AlviAhmed/RC_Car_433Mhz_Module_AVR/schematic/RC_Controller/rc_controller_basic/in_use_schem_pics/rc_motor_reciever_motor.png

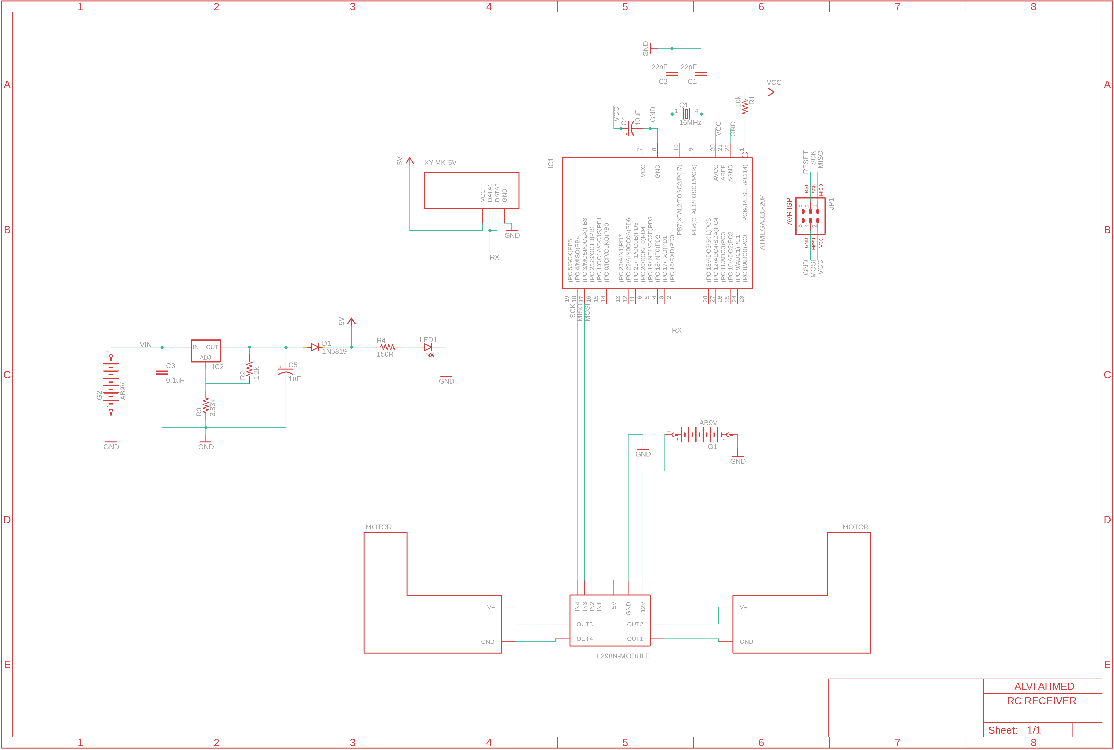
schematic/RC_Controller/rc_controller_basic/in_use_schem_pics/rc_motor_reciever_motor.png
