AlviAhmed/RC_Car_433Mhz_Module_AVR/schematic/RC_Controller/rc_controller_basic/prototype_schem_pics/rc_controller_basic.png

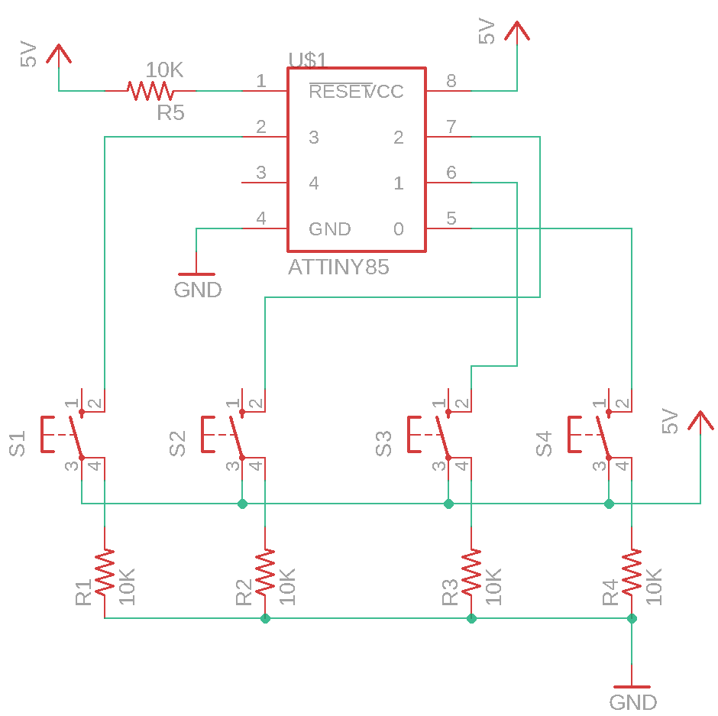
schematic/RC_Controller/rc_controller_basic/prototype_schem_pics/rc_controller_basic.png
