AlviAhmed/RC_Car_433Mhz_Module_AVR/schematic/RC_Controller/rc_controller_basic/rc_controller_prototype_reciever.sch

## EAGLE design schematic/RC_Controller/rc_controller_basic/rc_controller_prototype_reciever.sch (2020-10-17)

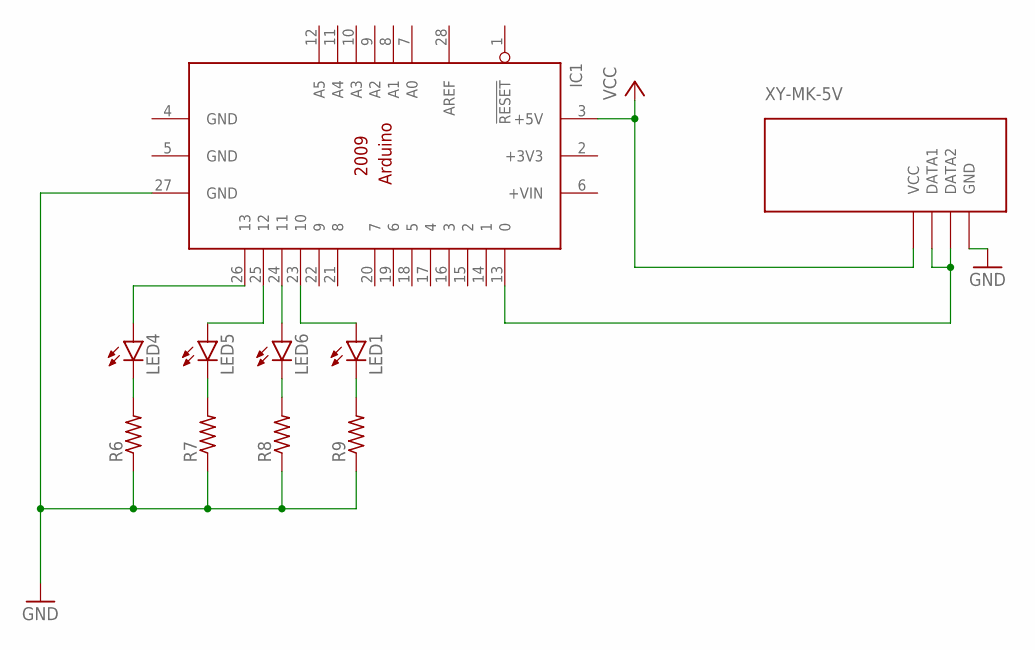
[picture p9: schematic rc_controller_prototype_reciever.sch]

Parts:
IC1: ARDUINO2009_10; ARDUINO2009
LED1, LED4, LED5, LED6: LED5MM
R6, R7, R8, R9: R-US_0204/7; 0204/7

Connections:
GND: IC1.27 (GND), R6.1, R7.1, R8.1, R9.1
unnamed: IC1.26 (13), LED4.A
unnamed: IC1.25 (12), LED5.A
unnamed: IC1.24 (11), LED6.A
unnamed: IC1.23 (10), LED1.A
unnamed: LED4.K (C), R6.2
unnamed: LED5.K (C), R7.2
unnamed: LED6.K (C), R8.2
unnamed: LED1.K (C), R9.2
VCC: IC1.3 (+5V)
