AlviAhmed/RC_Car_433Mhz_Module_AVR/schematic/RC_Controller/rc_controller_basic/rc_controller_prototype_transmitter.sch

## EAGLE design schematic/RC_Controller/rc_controller_basic/rc_controller_prototype_transmitter.sch (2020-10-17)

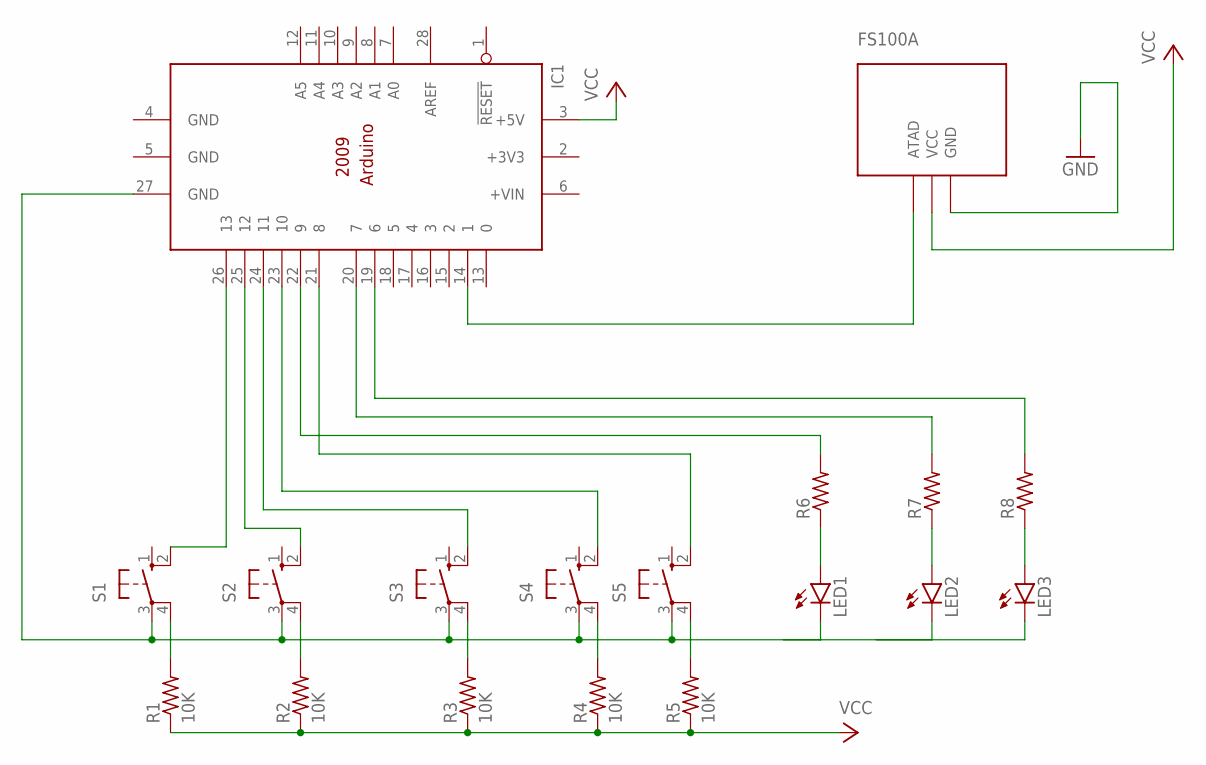
[picture p10: schematic rc_controller_prototype_transmitter.sch]

Parts:
IC1: ARDUINO2009_10; ARDUINO2009
LED1, LED2, LED3: LED5MM
R1, R2, R3, R4, R5: 10K; 0204/5
R6, R7, R8: R-US_0204/7; 0204/7
S1, S2, S3, S4, S5: 10-XX; B3F-10XX

Connections:
unnamed: IC1.26 (13), S1.2 (S1)
unnamed: R1.2, S1.4 (P1)
unnamed: R2.2, S2.4 (P1)
unnamed: R3.2, S3.4 (P1)
unnamed: R4.2, S4.4 (P1)
unnamed: IC1.22 (9), R6.2
unnamed: IC1.25 (12), S2.2 (S1)
unnamed: IC1.23 (10), S4.2 (S1)
unnamed: IC1.24 (11), S3.2 (S1)
unnamed: R5.2, S5.4 (P1)
unnamed: IC1.27 (GND), LED1.K (C), S1.3, S2.3, S3.3, S4.3, S5.3
unnamed: LED1.A, R6.1
unnamed: IC1.21 (8), S5.2 (S1)
unnamed: IC1.20 (7), R7.2
unnamed: LED2.A, R7.1
unnamed: IC1.19 (6), R8.2
unnamed: LED3.A, R8.1
VCC: IC1.3 (+5V), R1.1, R2.1, R3.1, R4.1, R5.1
