AlviAhmed/RC_Car_433Mhz_Module_AVR/schematic/RC_Controller/rc_controller_basic/rc_controller_reciever.sch

## EAGLE design schematic/RC_Controller/rc_controller_basic/rc_controller_reciever.sch (2020-10-17)

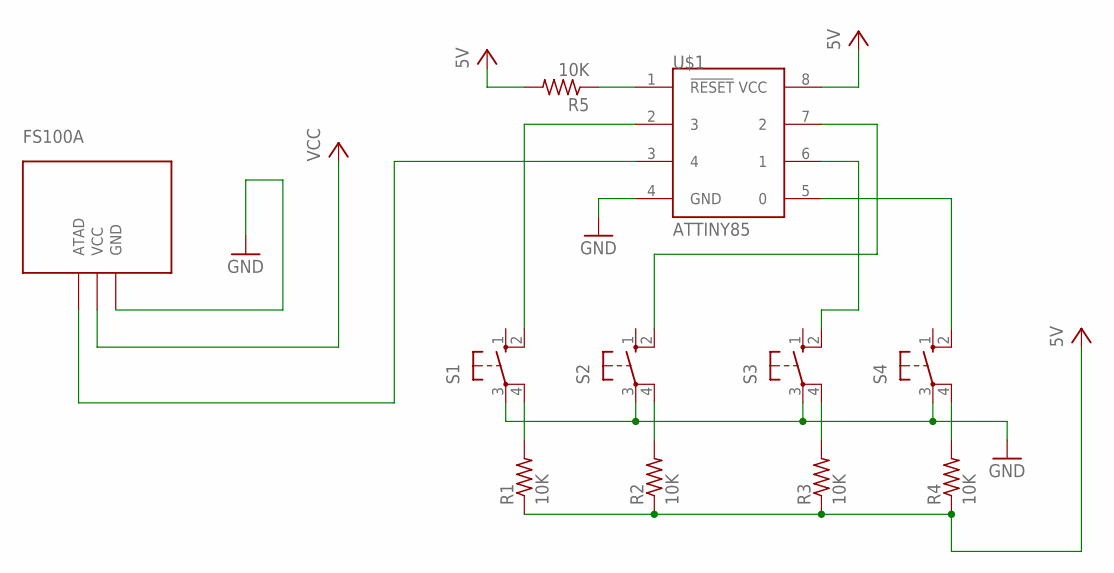
[picture p11: schematic rc_controller_reciever.sch, sheet 1]

Parts:
R1, R2, R3, R4, R5: 10K; 0204/5
S1, S2, S3, S4: 10-XX; B3F-10XX
U$1: ATTINY85; 8P3

Connections:
GND: S1.3, S2.3, S3.3, S4.3, U$1.4 (GND)
unnamed: R5.1, U$1.1 (!RESET)
unnamed: R1.2, S1.4 (P1)
unnamed: R2.2, S2.4 (P1)
unnamed: R3.2, S3.4 (P1)
unnamed: R4.2, S4.4 (P1)
unnamed: S1.2 (S1), U$1.2 (3)
unnamed: S2.2 (S1), U$1.7 (2)
unnamed: S3.2 (S1), U$1.6 (1)
unnamed: S4.2 (S1), U$1.5 (0)
TO_TRANSMITTER: U$1.3 (4)
VCC: R1.1, R2.1, R3.1, R4.1, R5.2, U$1.8 (VCC)
