AlviAhmed/RC_Car_433Mhz_Module_AVR/schematic/RC_Controller/rc_controller_basic/rc_controller_reciever_motor_actual.sch

## EAGLE design schematic/RC_Controller/rc_controller_basic/rc_controller_reciever_motor_actual.sch (2020-11-09)

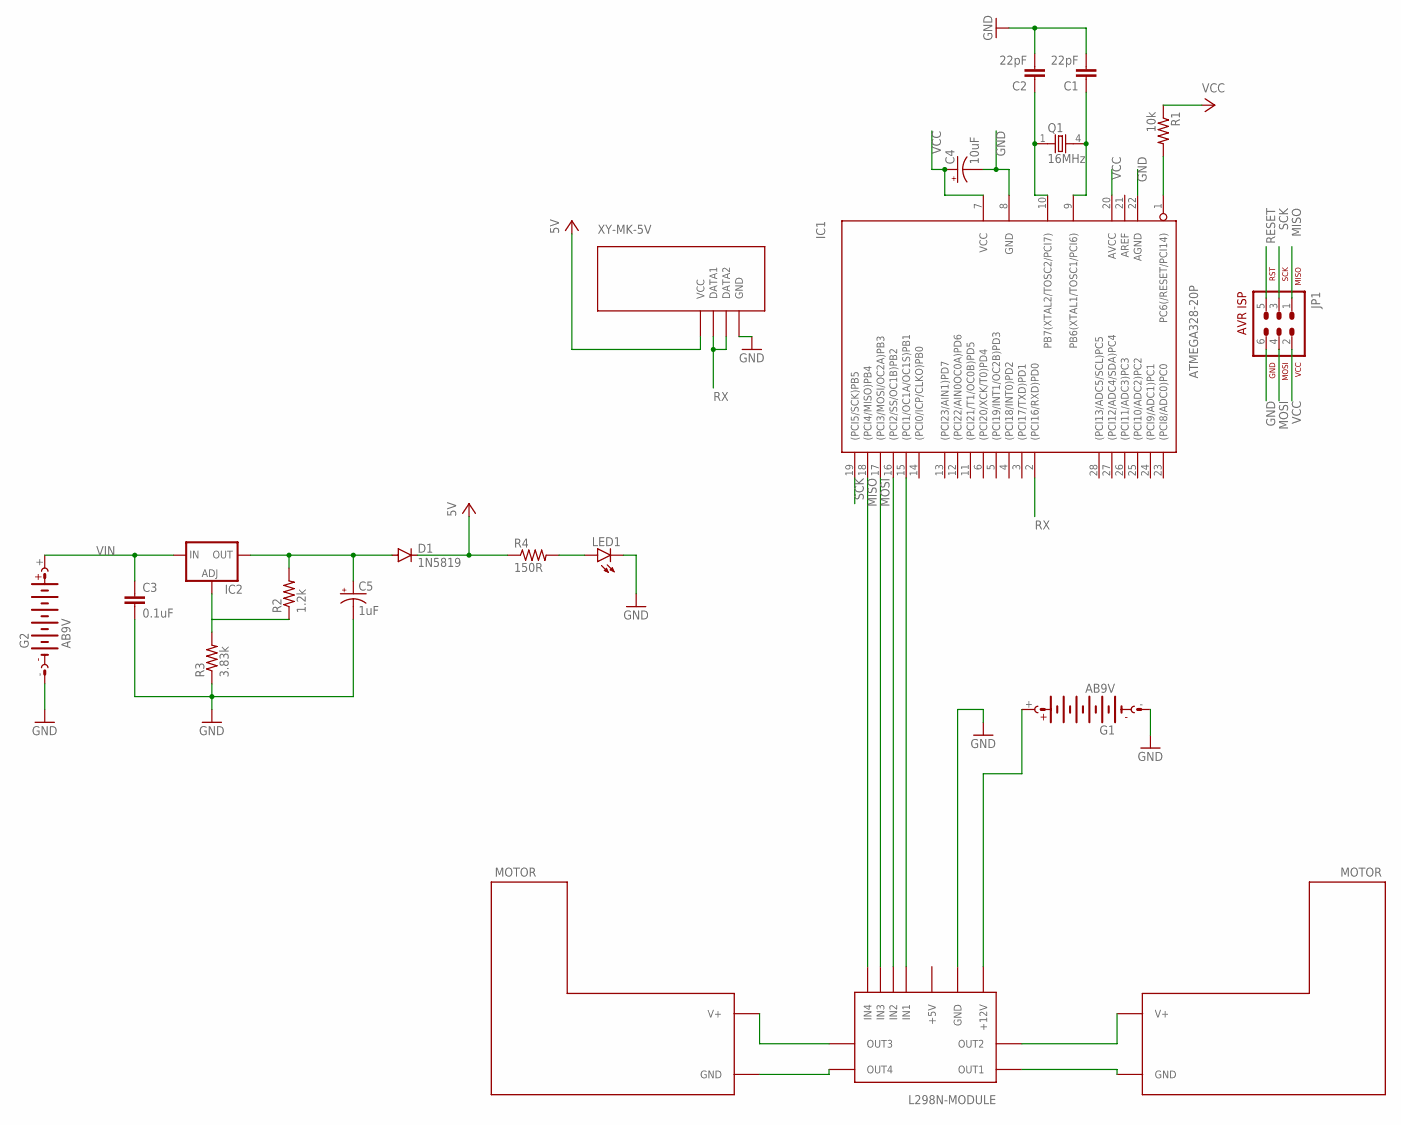
[picture p12: schematic rc_controller_reciever_motor_actual.sch]

Parts:
C1, C2: 22pF; C2.5-3
C3: 0.1uF; C2.5-3
C4: 10uF; 085CS_1AW
C5: 1uF; 153CLV-0810
D1: 1N5819; DO41-10
G1, G2: AB9V
IC1: ATMEGA328-20P; DIL28-3
IC2: LM317TL; 317TL
JP1: AVR-ISP-6VERT; AVR-ISP-6
LED1: LAP4-BOTTOM; P47F-BOTTOM
Q1: 16MHz; 86SMX
R1: 10k; 0204/7
R2: 1.2k; 0204/7
R3: 3.83k; 0204/7
R4: 150R; 0204/7

Connections:
GND: C1.2, C2.1, C2.2, C3.2, C4.-, C5.-, G1.-, G2.-, IC1.8 (GND), IC1.10 (PB7(XTAL2/TOSC2/PCI7)), IC1.22 (AGND), JP1.6, LED1.C, Q1.1, R3.1
MISO: IC1.18 ((PCI4/MISO)PB4), JP1.1
MOSI: IC1.17 ((PCI3/MOSI/OC2A)PB3), JP1.4
unnamed: IC2.1 (ADJ), R2.1, R3.2
unnamed: C1.1, IC1.9 (PB6(XTAL1/TOSC1/PCI6)), Q1.4 (2)
unnamed: IC1.1 (PC6(/RESET/PCI14)), R1.2
unnamed: C5.+, D1.A, IC2.2 (OUT), R2.2
unnamed: LED1.A, R4.2
RESET: JP1.5
RX: IC1.2 ((PCI16/RXD)PD0)
SCK: IC1.19 ((PCI5/SCK)PB5), JP1.3
VCC: C4.+, D1.C, IC1.7 (VCC), IC1.20 (AVCC), JP1.2, R1.1, R4.1
VIN: C3.1, G2.+, IC2.3 (IN)
