AlviAhmed/RC_Car_433Mhz_Module_AVR/schematic/RC_Controller/rc_controller_basic/rc_controller_reciever_motor_prototype.sch

## EAGLE design schematic/RC_Controller/rc_controller_basic/rc_controller_reciever_motor_prototype.sch (2020-10-23)

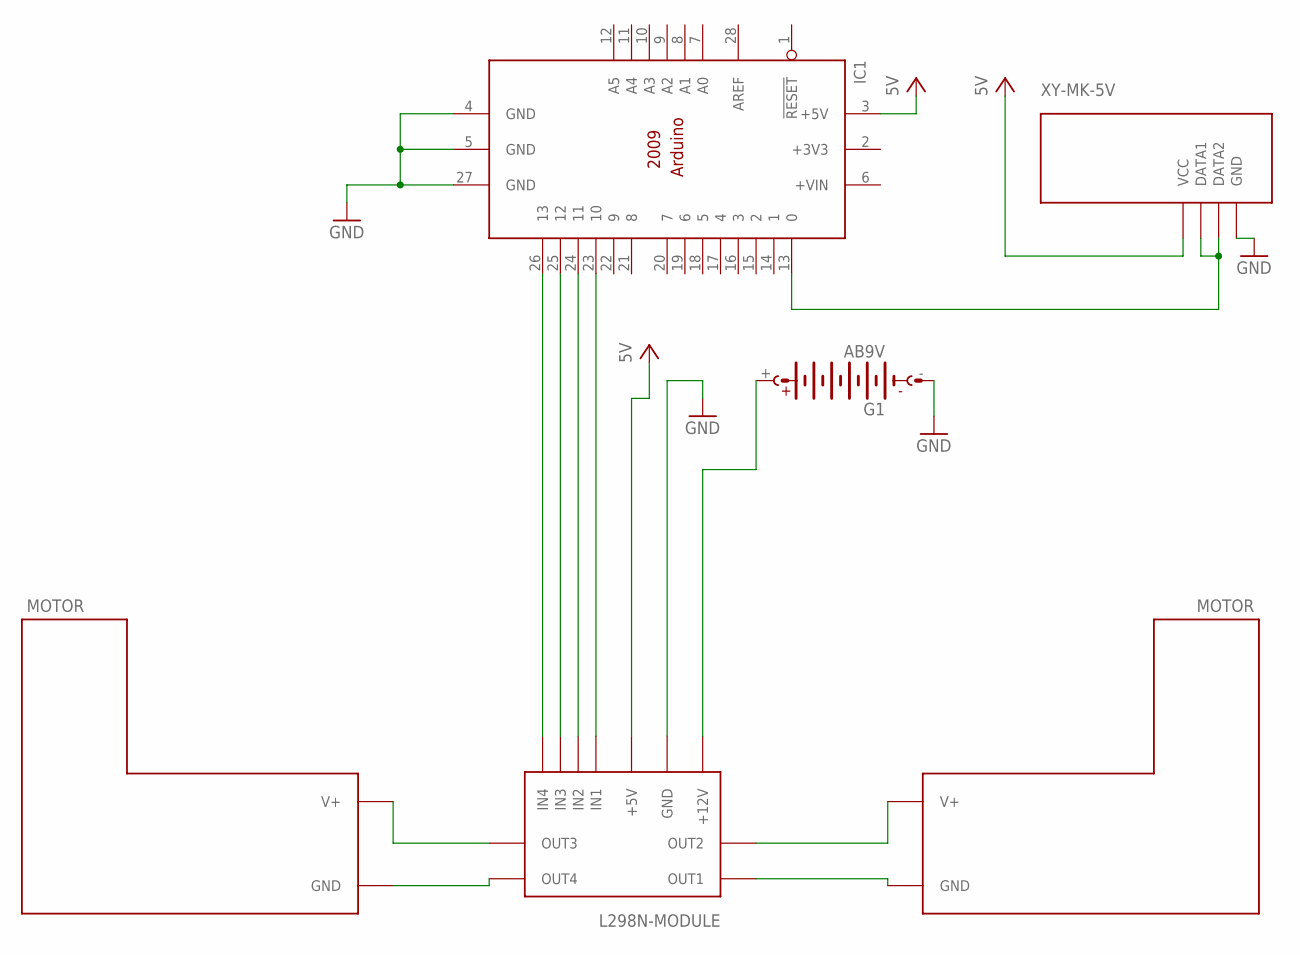
[picture p13: schematic rc_controller_reciever_motor_prototype.sch]

Parts:
G1: AB9V
IC1: ARDUINO2009_10; ARDUINO2009

Connections:
GND: G1.-, IC1.4 (GND), IC1.5 (GND), IC1.27 (GND)
VCC: IC1.3 (+5V)
