AlviAhmed/RC_Car_433Mhz_Module_AVR/schematic/RC_Controller/rc_controller_basic/rc_controller_transmitter_comp.sch

## EAGLE design schematic/RC_Controller/rc_controller_basic/rc_controller_transmitter_comp.sch (2020-11-09)

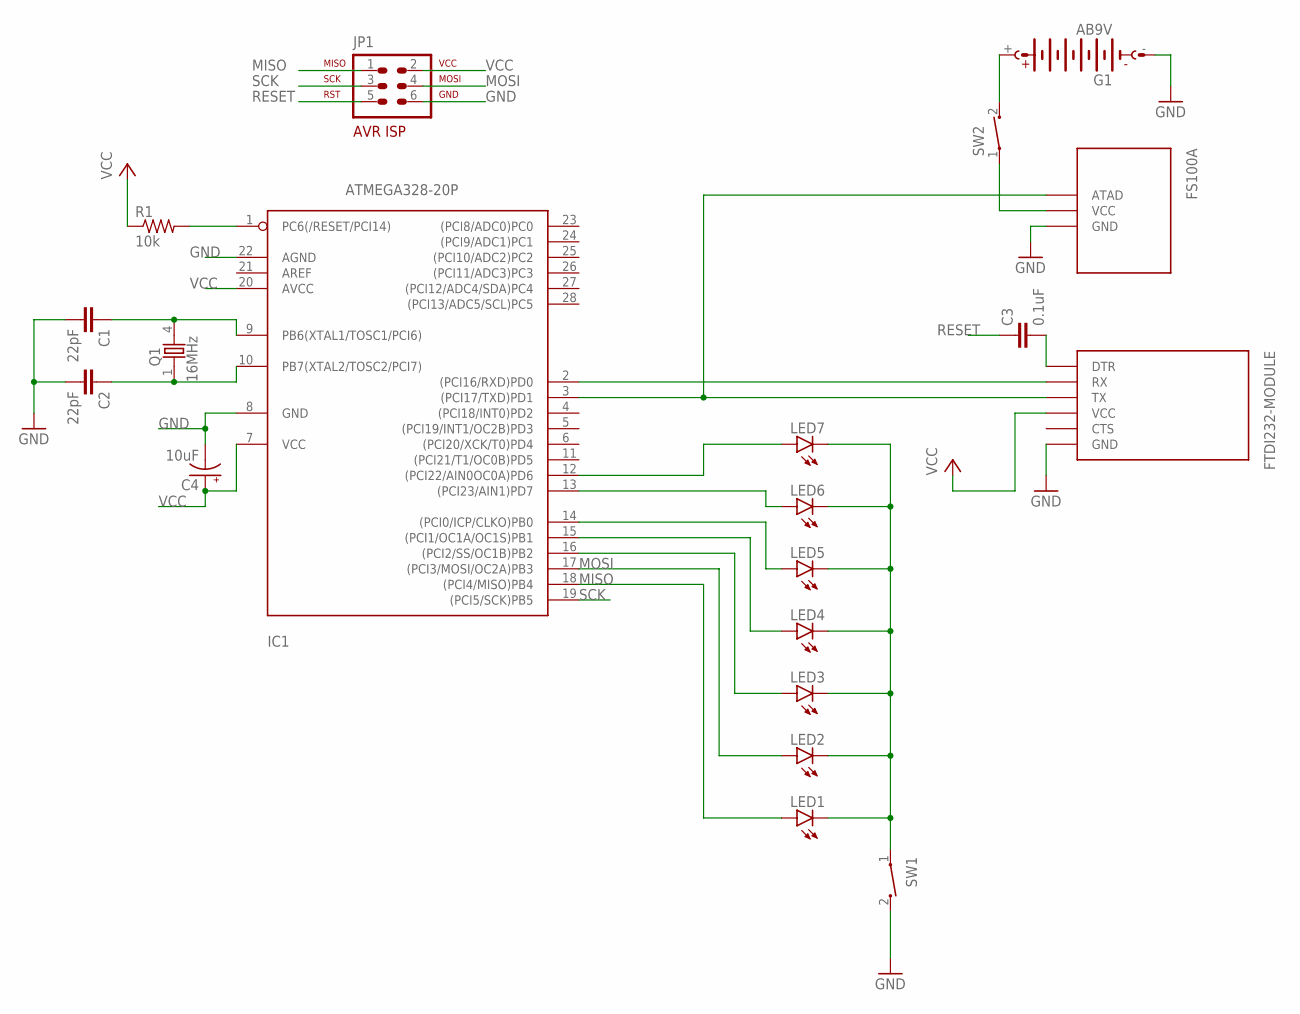
[picture p14: schematic rc_controller_transmitter_comp.sch]

Parts:
C1, C2: 22pF; C2.5-3
C3: 0.1uF; C2.5-3
C4: 10uF; 085CS_1AW
G1: AB9V
IC1: ATMEGA328-20P; DIL28-3
JP1: AVR-ISP-6VERT; AVR-ISP-6
LED1, LED2, LED3, LED4, LED5, LED6, LED7: LEDLUMILED; LUMILED
Q1: 16MHz; 86SMX
R1: 10k; 0204/7
SW1, SW2: CT10-XXXX-A2

Connections:
GND: C1.2, C2.1, C2.2, C4.-, G1.-, IC1.8 (GND), IC1.10 (PB7(XTAL2/TOSC2/PCI7)), IC1.22 (AGND), JP1.6, Q1.1, SW1.2
MISO: IC1.18 ((PCI4/MISO)PB4), JP1.1, LED1.2+ (A)
MOSI: IC1.17 ((PCI3/MOSI/OC2A)PB3), JP1.4, LED2.2+ (A)
unnamed: IC1.1 (PC6(/RESET/PCI14)), R1.2
unnamed: C1.1, IC1.9 (PB6(XTAL1/TOSC1/PCI6)), Q1.4 (2)
unnamed: IC1.16 ((PCI2/SS/OC1B)PB2), LED3.2+ (A)
unnamed: IC1.13 ((PCI23/AIN1)PD7), LED6.2+ (A)
unnamed: IC1.14 ((PCI0/ICP/CLKO)PB0), LED5.2+ (A)
unnamed: G1.+, SW2.2
unnamed: IC1.15 ((PCI1/OC1A/OC1S)PB1), LED4.2+ (A)
unnamed: IC1.12 ((PCI22/AIN0OC0A)PD6), LED7.2+ (A)
unnamed: LED1.4- (C), LED2.4- (C), LED3.4- (C), LED4.4- (C), LED5.4- (C), LED6.4- (C), LED7.4- (C), SW1.1
RESET: C3.1, JP1.5
SCK: IC1.19 ((PCI5/SCK)PB5), JP1.3
VCC: C4.+, IC1.7 (VCC), IC1.20 (AVCC), JP1.2, R1.1
