AlviAhmed/RC_Car_433Mhz_Module_AVR/schematic/RC_Controller/rc_controller_basic/voltage_regulator.sch

## EAGLE design schematic/RC_Controller/rc_controller_basic/voltage_regulator.sch (2020-10-17)

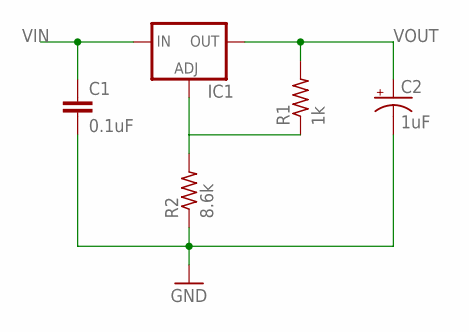
[picture p15: schematic voltage_regulator.sch]

Parts:
C1: 0.1uF; C2.5-3
C2: 1uF; 153CLV-0810
IC1: LM317TL; 317TL
R1: 1k; 0204/7
R2: 8.6k; 0204/7

Connections:
GND: C1.2, C2.-, R2.1
unnamed: IC1.1 (ADJ), R1.1, R2.2
VIN: C1.1, IC1.3 (IN)
VOUT: C2.+, IC1.2 (OUT), R1.2
