AlviAhmed/RC_Car_433Mhz_Module_AVR/avr_usart/maintx_debug.c

// *******************************************************
//AVR_USART_ATMEGA328p_TX
// *******************************************************

#include "tx_header_debug.h"

void nullByteIfEmpty(){
    if (UCSR0A & (1 << UDRE0)) { //if the UDRE register is empty, then send a null byte, just to make sure no junk is put in to the register
        UDR0 = 0x00;
    }
}

void appendTx(char data_byte)
{
    txBuffer[txWritePos] = data_byte;
    txWritePos++; //increment global write position as you are inputting things into the array
    if (txWritePos >= bufferSize){
        txWritePos  = 0;
    }
}

void txPacket(char rxByte, char command){
    txBuffer[0] = syncByte;
    txBuffer[1] = rxByte;
    txBuffer[2] = command;
}
void txPacketNeutral(char command){
    appendTx(command);
    appendTx(command);
    appendTx(command);
}

void debugging(){
    UDR0 = 'x';
    _delay_ms(delay_num);
    UDR0 = txBuffer[0];
    _delay_ms(delay_num);
    UDR0 = 'y';
    _delay_ms(delay_num);
    UDR0 = txBuffer[1];
    _delay_ms(delay_num);
    UDR0 = 'z';
    _delay_ms(delay_num);
    UDR0 = txBuffer[2];
}


void init(){
    DDRB |= (1 << PB0);
    PORTB &=~ (1 << PB0);
    DDRD |= (1 << PD2) | (1 << PD3) | ( 1 << PD7 ) | ( 1 << PD6 );
    PORTD &=~ (1 << PD2) | (1 << PD3) | ( 1 << PD7 ) | ( 1 << PD6 );

    DDRB &=~ (1 << PB5) | (1 << PB4) | (1 << PB3) | (1 << PB2) | (1 << PB1);
    PORTB |= (1 << PB5) | (1 << PB4) | (1 << PB3) | (1 << PB2) | (1 << PB1);

    //High and low bits
    UBRR0H = (ubbrn >> 8); 
    UBRR0L = ubbrn; 
    //////////////// 

//transimit and recieve enable
    UCSR0A = 0x00;
    UCSR0B = (1 << TXEN0) | (1 << TXCIE0) | (1 << RXCIE0) | (1 << RXEN0); //enabling tranmission interrupt
    UCSR0C = (1 << UCSZ01) | (1 << UCSZ00);  //8 bit data format

    UDR0 = 0;
    
// Pin interrupt config
    PCMSK0 |= (1 << PCINT5) | (1 << PCINT4) | (1 << PCINT3) | (1 << PCINT2) | (1 << PCINT1);
    PCICR |= (1 << PCIE0);
    sei();
    int delay_num = 10;
}


int main(void){
    init();
    while (1){
        if (ser_bool == 0){
            rxSerNum = num1;
            PORTD |= (1 << PD2);
            PORTD &=~ (1 << PD3);
        }
        else if (ser_bool == 1){
            rxSerNum = num2;
            PORTD &=~ (1 << PD2);
            PORTD |= (1 << PD3);
        }
    }
}  


ISR(PCINT0_vect){
    _delay_ms(5);
    if (but3){
        txPacket(rxSerNum, 'f');
        PORTB |= (1 << PB0);
    }
    else if (but2){
        txPacket(rxSerNum, 'b');
        PORTB |= (1 << PB0);
    }
    else if (but1){
        txPacket(rxSerNum, 'l');
        PORTB |= (1 << PB0);
    }
    else if (but0){
        txPacket(rxSerNum, 'r');
        PORTB |= (1 << PB0);
    }
    else if (butTog){
        ser_bool = !ser_bool;
        PORTB |= (1 << PB0);
    }
    else {
        txPacket(rxSerNum, 'n');
        PORTB &=~ (1 << PB0);
    }
}

ISR(USART_TX_vect) // once tx buffer is clear, set clear bit to accept new data
{
    if (txReadPos != bufferSize){ //now we are reading the info from the buffer index by index to be transmitted
        UDR0 = txBuffer[txReadPos]; //tx read pos just used to index the buffer data to be transmitted
        txReadPos ++;
        if (txReadPos >= bufferSize){
            txReadPos = 0;
        }
    }
}

ISR(BADISR_vect){
    PORTD ^= PD7;
}
