AlviAhmed/RC_Car_433Mhz_Module_AVR/(commit log)

2019-01-13 button interrupt working
2019-01-13 updated interrupt
2019-01-13 included 4 buttons, not working yet
    [main.c]
2019-01-13 4 buttons working with interrupt
2019-01-19 Realized that ADC will not work well for this application, will have to code
    [main_rx.c, main_tx.c]
2019-01-21 Lowered the frequency of the PWM for better sampling on the RX
2019-01-21 Finally was able to get the atiny to interpret PWM and duty cycle, and get the corresponding led to light up
2019-01-28 Added the states, now makes motors go forward, back ... etc.
2019-02-03 resolved low pin voltage issue, states working fine
    [main_rx.c]
2019-02-05 added schematic - incomplete
    [RC_tiny85.sch]
2019-02-05 States for motors working, wireless a little noisy, need to fiddle with some values
2019-02-06 Tweaked tolerances, duty cycle and freq to ensure less jitter
    [main_rx.c, main_tx.c]
2020-10-14 updated readme and repo
    [RC_tiny85.sch]
2020-10-16 recievier switcher button working
2020-10-17 added more schematics
    [RC_tiny85.sch, rc_controller_prototype_reciever.sch, rc_controller_prototype_transmitter.sch, rc_controller_reciever.sch, voltage_regulator.sch]
2020-10-23 updated schematic
    [rc_controller_reciever_motor_prototype.sch]
2020-10-27 rx fixed, recivievs packets IN ORDER, from sync to cmd, now when tx is turned on and off can resume function
    [mainrx.c, maintx.c]
2020-10-28 everything working, need to work on tx to make constant stream input to avoid states defaulting to high position
    [mainrx.c]
2020-11-05 updated schematics and code to allow for different rx serial
    [rc_controller_reciever_motor_actual.sch, rc_controller_transmitter_comp.sch]
2020-11-09 updated schematics
    [rc_controller_reciever_motor_actual.sch, rc_controller_transmitter_comp.sch]
